cr1tbit/antcontroller/antController.kicad_pcb

## KiCad design antController.kicad_pcb (2022-12-12)

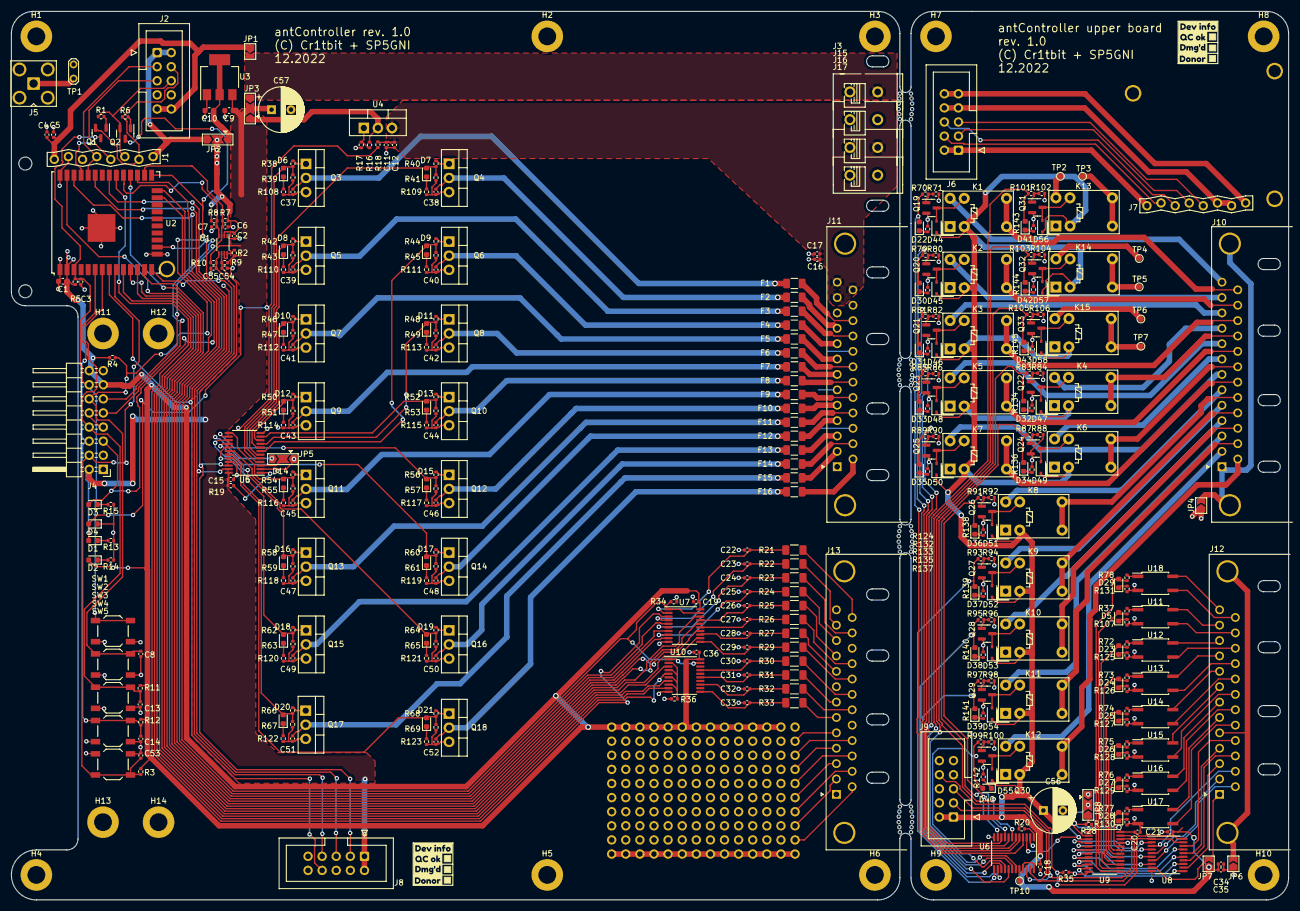
[picture p1: board antController.kicad_pcb from above]

Board: 2 copper layers, 230.0 x 160.0 mm, 402 parts (0 on the bottom side), 326 nets.

Parts:
C1, C9, C10: 10u; C_0603_1608Metric
C2, C3, C4, C8, C11, C13, C14, C15, C16, C18, C19, C20, C21, C34, C36, C53: 100n; C_0402_1005Metric
C5, C12, C17, C35: 1n; C_0402_1005Metric
C6, C7, C54, C55: 1n/DNP; C_0402_1005Metric
C22, C23, C24, C25, C26, C27, C28, C29, C30, C31, C32, C33, C37, C38, C39, C40, C41, C42, C43, C44, C45, C46, C47, C48, C49, C50, C51, C52: 10n; C_0402_1005Metric
C56, C57: 220u; CP_Radial_D8.0mm_P3.50mm
D1, D2, D3, D4, D5, D6, D7, D8, D9, D10, D11, D12, D13, D14, D15, D16, D17, D18, D19, D20, D21, D22, D23, D24, D25, D26, D27, D28, D29, D30, D31, D32, D33, D34, D35, D36, D37, D38, D39, D40, D41, D42, D43: LED_RED; LED_0603_1608Metric
D44, D45, D46, D47, D48, D49, D50, D51, D52, D53, D54, D55, D56, D57, D58: 1N4148WS; D_SOD-323
F1, F2, F3, F4, F5, F6, F7, F8, F9, F10, F11, F12, F13, F14, F15, F16: FUSE_1206; Fuse_1206_3216Metric
H1, H2, H3, H4, H5, H6, H11, H12, H13, H14: SCRHOLE; MountingHole_3.2mm_M3_ISO7380_Pad
H7, H8, H9, H10: HOLE_B2; MountingHole_3.2mm_M3_ISO7380_Pad
J1, J7: Lichtenprog_conn; Lichtenprog_board
J2, J6, J8, J9: IDC10; IDC-Header_2x05_P2.54mm_Vertical
J3, J15, J16, J17: VIN; DG235-5.0
J4: FRONT_PANEL; PinHeader_2x08_P2.54mm_Horizontal
J5: SMA CONN; SMA_Amphenol_901-143_Horizontal
J10, J11, J12, J13: DB25_Male_MountingHoles; DSUB-25_Male_Horizontal_P2.77x2.84mm_EdgePinOffset9.90mm_Ho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
J14: Proto_matrix_14x10
JP1: 5V_PROG; SolderJumper-2_P1.3mm_Open_TrianglePad1.0x1.5mm
JP2: 3V3_SEL; SolderJumper-3_P2.0mm_Open_TrianglePad1.0x1.5mm
JP3: 5V_SEL; SolderJumper-3_P2.0mm_Open_TrianglePad1.0x1.5mm
JP4, JP6: GND_CONN; SolderJumper-2_P1.3mm_Open_TrianglePad1.0x1.5mm
JP5, JP8: IOEX_A2_SEL; SolderJumper-3_P2.0mm_Open_TrianglePad1.0x1.5mm
JP7: 5V_CONN; SolderJumper-2_P1.3mm_Open_TrianglePad1.0x1.5mm
K1, K2, K3, K4, K5, K6, K7, K8, K9, K10, K11, K12, K13, K14, K15: G5V-1; Relay_SPDT_Omron_G5V-1
Q1, Q2, Q19, Q20, Q21, Q22, Q23, Q24, Q25, Q26, Q27, Q28, Q29, Q30, Q31, Q32, Q33: MMBT3904; SOT-23
Q3, Q4, Q5, Q6, Q7, Q8, Q9, Q10, Q11, Q12, Q13, Q14, Q15, Q16, Q17, Q18: BUZ11; TO-220-3_Vertical
R1, R3, R4, R5, R6, R11, R12, R19, R20, R28, R34, R35, R36, R39, R41, R43, R45, R47, R49, R51, R53, R55, R57, R59, R61, R63, R65, R67, R69, R71, R80, R82, R84, R86, R88, R90, R92, R94, R96, R98, R100, R102, R104, R106: 10k; R_0402_1005Metric
R2: 200k; R_0402_1005Metric
R7, R8, R9, R10, R37, R38, R40, R42, R44, R46, R48, R50, R52, R54, R56, R58, R60, R62, R64, R66, R68, R70, R72, R73, R74, R75, R76, R77, R78, R79, R81, R83, R85, R87, R89, R91, R93, R95, R97, R99, R101, R103, R105: 4k7; R_0402_1005Metric
R13, R107, R108, R109, R110, R111, R112, R113, R114, R115, R116, R117, R118, R119, R120, R121, R122, R123, R124, R125, R126, R127, R128, R129, R130, R131, R132, R133, R134, R135, R136, R137, R138, R139, R140, R141, R142, R143, R144, R145: 33k; R_0402_1005Metric
R14, R15: 15k; R_0402_1005Metric
R16: 240; R_0402_1005Metric
R17: 720; R_0402_1005Metric
R18: 100k; R_0402_1005Metric
R21, R22, R23, R24, R25, R26, R27, R29, R30, R31, R32, R33: 10k_1206; R_1206_3216Metric_Pad1.30x1.75mm_HandSolder
SW1: B_RST; SW_SPST_TL3342
SW2: B1/BOOT; SW_SPST_TL3342
SW3: B2; SW_SPST_TL3342
SW4, SW5: B3; SW_SPST_TL3342
TP1: SMA PADS; TestPoint_2Pads_Pitch2.54mm_Drill0.8mm
TP2, TP3, TP4, TP5, TP6, TP7: RLPAD; TestPoint_Pad_D1.0mm
TP10: IOPAD; TestPoint_Pad_D1.0mm
U1: PCA9306DC; VSSOP-8_2.3x2mm_P0.5mm
U2: ESP32-WROOM-32U
U3: AZ1117-3.3; SOT-223-3_TabPin2
U4: LM317_TO-220; TO-220-3_Vertical
U5, U6, U9: PCA9555PW; TSSOP-24_4.4x7.8mm_P0.65mm
U7, U8, U10: 74HC244; TSSOP-20_4.4x6.5mm_P0.65mm
U11, U12, U13, U14, U15, U16, U17, U18: LTV-356T; SO-4_4.4x3.6mm_P2.54mm
kibuzzard-6394C46A, kibuzzard-6394C46A#2: G***; kibuzzard-6394C46A
kibuzzard-6394C47E, kibuzzard-6394C47E#2: G***; kibuzzard-6394C47E
kibuzzard-6394C445, kibuzzard-6394C445#2: G***; kibuzzard-6394C445
kibuzzard-6394C560, kibuzzard-6394C560#2: G***; kibuzzard-6394C560

Connections:
+3.3V: C1.1, C2.1, C19.1, C36.1, D2.2 (A), J4.13, J4.16, J14.A2, J14.A3, J14.A4, J14.A5, J14.A6, J14.A7, J14.A8, J14.A9, J14.A10, J14.A11, J14.A12, J14.A13, J14.A14, JP2.2 (C), R3.2, R4.2, R5.2, R7.2, R8.2, R11.2, R12.2, U1.2 (VREF1), U2.2 (VDD), U7.20 (VCC), U10.20 (VCC)
+5V: C9.1, C15.1, C57.1, D1.2 (A), J4.2, J8.1, J8.2, JP3.2 (C), JP5.3 (B), R2.2, R9.2, R10.2, R19.2, U3.3 (VI), U5.24 (VDD)
+5VD: C18.1, C20.1, C21.1, C34.2, C35.2, C56.1, D44.1 (K), D45.1 (K), D46.1 (K), D47.1 (K), D48.1 (K), D49.1 (K), D50.1 (K), D51.1 (K), D52.1 (K), D53.1 (K), D54.1 (K), D55.1 (K), D56.1 (K), D57.1 (K), D58.1 (K), J9.1, J9.2, JP7.1 (A), JP8.3 (B), K1.2, K2.2, K3.2, K4.2, K5.2, K6.2, K7.2, K8.2, K9.2, K10.2, K11.2, K12.2, K13.2, K14.2, K15.2, R20.2, R28.2, U6.21 (A0), U6.24 (VDD), U8.20 (VCC), U9.2 (A1), U9.24 (VDD)
+VDC: C11.1, C12.1, C16.1, C17.1, J11.12, J11.13, J11.25, J16.1, R18.2, U4.3 (VI)
/5V_IN: J3.1, JP1.2 (B), JP3.3 (B)
/B2: C13.1, J4.8, R11.1, SW3.2, U2.7 (IO35)
/B3: C14.1, J4.6, R12.1, SW4.2, U2.6 (IO34)
/B4: C53.1, J4.4, R3.1, SW5.2, U2.9 (IO33)
/Back connectors/B2_OUT_BUF_ENA: J9.8, R35.2, U8.1 (1OE), U8.19 (2OE)
/Back connectors/B2_PROG_RX: J6.5, J7.5 (PROG_TX)
/Back connectors/B2_PROG_TX: J6.3, J7.4 (PROG_RX)
/Back connectors/B2_SCL: J9.3, U6.23 (SDA), U9.23 (SDA)
/Back connectors/B2_SDA: J9.5, U6.22 (SCL), U9.22 (SCL)
/Back connectors/BUFF1: J12.17, U8.18 (1Y0)
/Back connectors/BUFF2: J12.4, U8.16 (1Y1)
/Back connectors/BUFF3: J12.16, U8.14 (1Y2)
/Back connectors/BUFF4: J12.3, U8.12 (1Y3)
/Back connectors/BUFF5: J12.15, U8.3 (2Y0)
/Back connectors/BUFF6: J12.2, U8.5 (2Y1)
/Back connectors/BUFF7: J12.14, U8.7 (2Y2)
/Back connectors/BUFF8: J12.1, JP7.2 (B), U8.9 (2Y3)
/Back connectors/G_SINK1: D6.2 (A), R38.2, R39.2, U5.4 (IO0_0)
/Back connectors/G_SINK2: D7.2 (A), R40.2, R41.2, U5.5 (IO0_1)
/Back connectors/G_SINK3: D8.2 (A), R42.2, R43.2, U5.6 (IO0_2)
/Back connectors/G_SINK4: D9.2 (A), R44.2, R45.2, U5.7 (IO0_3)
/Back connectors/G_SINK5: D10.2 (A), R46.2, R47.2, U5.8 (IO0_4)
/Back connectors/G_SINK6: D11.2 (A), R48.2, R49.2, U5.9 (IO0_5)
/Back connectors/G_SINK7: D12.2 (A), R50.2, R51.2, U5.10 (IO0_6)
/Back connectors/G_SINK8: D13.2 (A), R52.2, R53.2, U5.11 (IO0_7)
/Back connectors/G_SINK9: D14.2 (A), R54.2, R55.2, U5.13 (IO1_0)
/Back connectors/G_SINK10: D15.2 (A), R56.2, R57.2, U5.14 (IO1_1)
/Back connectors/G_SINK11: D16.2 (A), R58.2, R59.2, U5.15 (IO1_2)
/Back connectors/G_SINK12: D17.2 (A), R60.2, R61.2, U5.16 (IO1_3)
/Back connectors/G_SINK13: D18.2 (A), R62.2, R63.2, U5.17 (IO1_4)
/Back connectors/G_SINK14: D19.2 (A), R64.2, R65.2, U5.18 (IO1_5)
/Back connectors/G_SINK15: D20.2 (A), R66.2, R67.2, U5.19 (IO1_6)
/Back connectors/G_SINK16: D21.2 (A), R68.2, R69.2, U5.20 (IO1_7)
/Back connectors/OC1_A: D29.2 (A), R78.2, U9.13 (IO1_0)
/Back connectors/OC1_C: J12.13, U18.4
/Back connectors/OC1_E: J12.25, U18.3
/Back connectors/OC2_A: D5.2 (A), R37.2, U9.14 (IO1_1)
/Back connectors/OC2_C: J12.12, U11.4
/Back connectors/OC2_E: J12.24, U11.3
/Back connectors/OC3_A: D23.2 (A), R72.2, U9.15 (IO1_2)
/Back connectors/OC3_C: J12.11, U12.4
/Back connectors/OC3_E: J12.23, U12.3
/Back connectors/OC4_A: D24.2 (A), R73.2, U9.16 (IO1_3)
/Back connectors/OC4_C: J12.10, U13.4
/Back connectors/OC4_E: J12.22, U13.3
/Back connectors/OC5_A: D25.2 (A), R74.2, U9.17 (IO1_4)
/Back connectors/OC5_C: J12.9, U14.4
/Back connectors/OC5_E: J12.21, U14.3
/Back connectors/OC6_A: D26.2 (A), R75.2, U9.18 (IO1_5)
/Back connectors/OC6_C: J12.8, U15.4
/Back connectors/OC6_E: J12.20, U15.3
/Back connectors/OC7_A: D27.2 (A), R76.2, U9.19 (IO1_6)
/Back connectors/OC7_C: J12.7, U16.4
/Back connectors/OC7_E: J12.19, U16.3
/Back connectors/OC8_A: D28.2 (A), R77.2, U9.20 (IO1_7)
/Back connectors/OC8_C: J12.6, U17.4
/Back connectors/OC8_E: J12.18, U17.3
/Back connectors/RL1_A: J10.13, K1.10
/Back connectors/RL1_B: J10.25, K1.5, K1.6
/Back connectors/RL2_A: J10.12, K2.10
/Back connectors/RL2_B: J10.24, K2.5, K2.6
/Back connectors/RL3_A: J10.11, K3.10
/Back connectors/RL3_B: J10.23, K3.5, K3.6
/Back connectors/RL4_A: J10.10, K4.10
/Back connectors/RL4_B: J10.22, K4.5, K4.6
/Back connectors/RL5_A: J10.9, K5.10
/Back connectors/RL5_B: J10.21, K5.5, K5.6
/Back connectors/RL6_A: J10.8, K6.10
/Back connectors/RL6_B: J10.20, K6.5, K6.6
/Back connectors/RL7_A: J10.7, K7.10
/Back connectors/RL7_B: J10.19, K7.5, K7.6
/Back connectors/RL8_A: J10.6, K8.10
/Back connectors/RL8_B: J10.18, K8.5, K8.6
/Back connectors/RL9_A: J10.5, K9.10
/Back connectors/RL9_B: J10.17, K9.5, K9.6
/Back connectors/RL10_A: J10.4, K10.10
/Back connectors/RL10_B: J10.16, K10.5, K10.6
/Back connectors/RL11_A: J10.3, K11.10
/Back connectors/RL11_B: J10.15, K11.5, K11.6
/Back connectors/RL12_A: J10.2, K12.10
/Back connectors/RL12_B: J10.14, K12.5, K12.6
/Back connectors/RL13_A: K13.10, TP2.1
/Back connectors/RL13_B: K13.5, K13.6, TP3.1
/Back connectors/RL14_A: K14.10, TP4.1
/Back connectors/RL14_B: K14.5, K14.6, TP5.1
/Back connectors/RL15_A: K15.10, TP6.1
/Back connectors/RL15_B: K15.5, K15.6, TP7.1
/Back connectors/RL_CTRL1: D22.2 (A), R70.2, U6.4 (IO0_0)
/Back connectors/RL_CTRL2: D30.2 (A), R79.2, U6.5 (IO0_1)
/Back connectors/RL_CTRL3: D31.2 (A), R81.2, U6.6 (IO0_2)
/Back connectors/RL_CTRL4: D32.2 (A), R83.2, U6.7 (IO0_3)
/Back connectors/RL_CTRL5: D33.2 (A), R85.2, U6.8 (IO0_4)
/Back connectors/RL_CTRL6: D34.2 (A), R87.2, U6.9 (IO0_5)
/Back connectors/RL_CTRL7: D35.2 (A), R89.2, U6.10 (IO0_6)
/Back connectors/RL_CTRL8: D36.2 (A), R91.2, U6.11 (IO0_7)
/Back connectors/RL_CTRL9: D37.2 (A), R93.2, U6.13 (IO1_0)
/Back connectors/RL_CTRL10: D38.2 (A), R95.2, U6.14 (IO1_1)
/Back connectors/RL_CTRL11: D39.2 (A), R97.2, U6.15 (IO1_2)
/Back connectors/RL_CTRL12: D40.2 (A), R99.2, U6.16 (IO1_3)
/Back connectors/RL_CTRL13: D41.2 (A), R101.2, U6.17 (IO1_4)
/Back connectors/RL_CTRL14: D42.2 (A), R103.2, U6.18 (IO1_5)
/Back connectors/RL_CTRL15: D43.2 (A), R105.2, U6.19 (IO1_6)
/Back connectors/SINK1: C37.1, F1.1, Q3.2 (D)
/Back connectors/SINK2: C38.1, F2.1, Q4.2 (D)
/Back connectors/SINK3: C39.1, F3.1, Q5.2 (D)
/Back connectors/SINK4: C40.1, F4.1, Q6.2 (D)
/Back connectors/SINK5: C41.1, F5.1, Q7.2 (D)
/Back connectors/SINK6: C42.1, F6.1, Q8.2 (D)
/Back connectors/SINK7: C43.1, F7.1, Q9.2 (D)
/Back connectors/SINK8: C44.1, F8.1, Q10.2 (D)
/Back connectors/SINK9: C45.1, F9.1, Q11.2 (D)
/Back connectors/SINK10: C46.1, F10.1, Q12.2 (D)
/Back connectors/SINK11: C47.1, F11.1, Q13.2 (D)
/Back connectors/SINK12: C48.1, F12.1, Q14.2 (D)
/Back connectors/SINK13: C49.1, F13.1, Q15.2 (D)
/Back connectors/SINK14: C50.1, F14.1, Q16.2 (D)
/Back connectors/SINK15: C51.1, F15.1, Q17.2 (D)
/Back connectors/SINK16: C52.1, F16.1, Q18.2 (D)
/ESP_BOOT: C8.1, J4.12, Q2.3 (C), R4.1, SW2.2, U2.25 (IO0)
/ESP_EN: C3.1, J4.14, Q1.3 (C), R5.1, SW1.2, U2.3 (EN)
/I2C_RST: J8.7, U2.14 (IO12)
/IN_BUFF_ENA: R34.2, U2.16 (IO13), U7.1 (1OE), U7.19 (2OE), U10.1 (1OE), U10.19 (2OE)
/IO14: U2.13 (IO14), U7.18 (1Y0)
/IO15: U2.23 (IO15), U7.16 (1Y1)
/IO16: U2.27 (IO16), U7.14 (1Y2)
/IO17: U2.28 (IO17), U7.12 (1Y3)
/IO18: U2.30 (IO18), U7.3 (2Y0)
/IO19: U2.31 (IO19), U7.5 (2Y1)
/IO21: U2.33 (IO21), U7.7 (2Y2)
/IO22: U2.36 (IO22), U7.9 (2Y3)
/IO23: U2.37 (IO23), U10.3 (2Y0)
/IO25: U2.10 (IO25), U10.5 (2Y1)
/IO26: U2.11 (IO26), U10.7 (2Y2)
/IO27: U2.12 (IO27), U10.9 (2Y3)
/LED_STATUS: D3.2 (A), J4.5, U2.24 (IO2)
/OUT_BUF_ENA: J8.8, U2.8 (IO32)
/PROG_3V3: J1.1 (VDD), J2.1, J2.2, JP2.3 (B)
/PROG_5V: C4.1, C5.1, J1.8 (5V), J2.9, J2.10, JP1.1 (A)
/PROG_DTR: J1.3 (DTR), J2.6, Q2.2 (E), R1.1
/PROG_RTS: J1.2 (RTS), J2.4, Q1.2 (E), R6.1
/RXD: J1.5 (PROG_TX), J2.3, U2.34 (RXD0/IO3)
/SCL: C6.1, J4.11, R7.1, U1.3 (SCL1), U2.26 (IO4)
/SCL_5V: C54.1, J8.3, R9.1, U1.6 (SCL2), U5.22 (SCL)
/SDA: C7.1, J4.9, R8.1, U1.4 (SDA1), U2.29 (IO5)
/SDA_5V: C55.1, J8.5, R10.1, U1.5 (SDA2), U5.23 (SDA)
/TXD: J1.4 (PROG_RX), J2.5, U2.35 (TXD0/IO1)
GND: C1.2, C2.2, C3.2, C4.2, C5.2, C6.2, C7.2, C8.2, C9.2, C10.2, C11.2, C12.2, C13.2, C14.2, C15.2, C16.2, C17.2, C19.2, C22.2, C23.2, C24.2, C25.2, C26.2, C27.2, C28.2, C29.2, C30.2, C31.2, C32.2, C33.2, C36.2, C37.2, C38.2, C39.2, C40.2, C41.2, C42.2, C43.2, C44.2, C45.2, C46.2, C47.2, C48.2, C49.2, C50.2, C51.2, C52.2, C53.2, C54.2, C55.2, C57.2, D4.1 (K), H1.1, H2.1, H3.1, H4.1, H5.1, H6.1, H11.1, H12.1, H13.1, H14.1, J1.6 (GND), J1.7 (GND), J2.7, J2.8, J4.7, J4.10, J4.15, J5.2 (Ext), J8.9, J8.10, J11.0 (PAD), J11.1, J11.6, J11.11, J11.16, J11.21, J11.24, J13.0 (PAD), J13.1, J13.8, J13.13, J13.18, J13.23, J14.A1, J14.J1, J14.J2, J14.J3, J14.J4, J14.J5, J14.J6, J14.J7, J14.J8, J14.J9, J14.J10, J14.J11, J14.J12, J14.J13, J14.J14, J15.1, J17.1, JP5.1 (A), Q3.3 (S), Q4.3 (S), Q5.3 (S), Q6.3 (S), Q7.3 (S), Q8.3 (S), Q9.3 (S), Q10.3 (S), Q11.3 (S), Q12.3 (S), Q13.3 (S), Q14.3 (S), Q15.3 (S), Q16.3 (S), Q17.3 (S), Q18.3 (S), R13.1, R14.1, R15.1, R17.1, R34.1, R36.1, R39.1, R41.1, R43.1, R45.1, R47.1, R49.1, R51.1, R53.1, R55.1, R57.1, R59.1, R61.1, R63.1, R65.1, R67.1, R69.1, R108.1, R109.1, R110.1, R111.1, R112.1, R113.1, R114.1, R115.1, R116.1, R117.1, R118.1, R119.1, R120.1, R121.1, R122.1, R123.1, SW1.1, SW2.1, SW3.1, SW4.1, SW5.1, TP1.1, U1.1 (GND), U2.1 (GND), U2.15 (GND), U2.38 (GND), U2.39 (GND), U3.1 (GND), U5.2 (A1), U5.12 (VSS), U5.21 (A0), U7.10 (GND), U10.10 (GND)
GND2: C18.2, C20.2, C21.2, C34.1, C35.1, C56.2, H7.1, H8.1, H9.1, H10.1, J9.9, J9.10, JP4.1 (A), JP6.1 (A), JP8.1 (A), Q19.2 (E), Q20.2 (E), Q21.2 (E), Q22.2 (E), Q23.2 (E), Q24.2 (E), Q25.2 (E), Q26.2 (E), Q27.2 (E), Q28.2 (E), Q29.2 (E), Q30.2 (E), Q31.2 (E), Q32.2 (E), Q33.2 (E), R35.1, R71.1, R80.1, R82.1, R84.1, R86.1, R88.1, R90.1, R92.1, R94.1, R96.1, R98.1, R100.1, R102.1, R104.1, R106.1, R107.1, R124.1, R125.1, R126.1, R127.1, R128.1, R129.1, R130.1, R131.1, R132.1, R133.1, R134.1, R135.1, R136.1, R137.1, R138.1, R139.1, R140.1, R141.1, R142.1, R143.1, R144.1, R145.1, U6.2 (A1), U6.12 (VSS), U8.10 (GND), U9.12 (VSS), U9.21 (A0), U11.2, U12.2, U13.2, U14.2, U15.2, U16.2, U17.2, U18.2
unnamed: C10.1, JP2.1 (A), U3.2 (VO)
unnamed: C22.1, R21.2, U7.2 (1A0)
unnamed: C23.1, R22.2, U7.4 (1A1)
unnamed: C24.1, R23.2, U7.6 (1A2)
unnamed: C25.1, R24.2, U7.8 (1A3)
unnamed: C26.1, R25.2, U7.17 (2A0)
unnamed: C27.1, R26.2, U7.15 (2A1)
unnamed: C28.1, R27.2, U7.13 (2A2)
unnamed: C29.1, R29.2, U7.11 (2A3)
unnamed: C30.1, R30.2, U10.17 (2A0)
unnamed: C31.1, R31.2, U10.15 (2A1)
unnamed: C32.1, R32.2, U10.13 (2A2)
unnamed: C33.1, R33.2, U10.11 (2A3)
unnamed: D1.1 (K), R13.2
unnamed: D2.1 (K), R14.2
unnamed: D3.1 (K), R15.2
unnamed: D4.2 (A), R18.1
unnamed: D5.1 (K), R107.2
unnamed: D6.1 (K), R108.2
unnamed: D7.1 (K), R109.2
unnamed: D8.1 (K), R110.2
unnamed: D9.1 (K), R111.2
unnamed: D10.1 (K), R112.2
unnamed: D11.1 (K), R113.2
unnamed: D12.1 (K), R114.2
unnamed: D13.1 (K), R115.2
unnamed: D14.1 (K), R116.2
unnamed: D15.1 (K), R117.2
unnamed: D16.1 (K), R118.2
unnamed: D17.1 (K), R119.2
unnamed: D18.1 (K), R120.2
unnamed: D19.1 (K), R121.2
unnamed: D20.1 (K), R122.2
unnamed: D21.1 (K), R123.2
unnamed: D22.1 (K), R124.2
unnamed: D23.1 (K), R125.2
unnamed: D24.1 (K), R126.2
unnamed: D25.1 (K), R127.2
unnamed: D26.1 (K), R128.2
unnamed: D27.1 (K), R129.2
unnamed: D28.1 (K), R130.2
unnamed: D29.1 (K), R131.2
unnamed: D30.1 (K), R132.2
unnamed: D31.1 (K), R133.2
unnamed: D32.1 (K), R134.2
unnamed: D33.1 (K), R135.2
unnamed: D34.1 (K), R136.2
unnamed: D35.1 (K), R137.2
unnamed: D36.1 (K), R138.2
unnamed: D37.1 (K), R139.2
unnamed: D38.1 (K), R140.2
unnamed: D39.1 (K), R141.2
unnamed: D40.1 (K), R142.2
unnamed: D41.1 (K), R143.2
unnamed: D42.1 (K), R144.2
unnamed: D43.1 (K), R145.2
unnamed: D44.2 (A), K1.9, Q19.3 (C)
unnamed: D45.2 (A), K2.9, Q20.3 (C)
unnamed: D46.2 (A), K3.9, Q21.3 (C)
unnamed: D47.2 (A), K4.9, Q22.3 (C)
unnamed: D48.2 (A), K5.9, Q23.3 (C)
unnamed: D49.2 (A), K6.9, Q24.3 (C)
unnamed: D50.2 (A), K7.9, Q25.3 (C)
unnamed: D51.2 (A), K8.9, Q26.3 (C)
unnamed: D52.2 (A), K9.9, Q27.3 (C)
unnamed: D53.2 (A), K10.9, Q28.3 (C)
unnamed: D54.2 (A), K11.9, Q29.3 (C)
unnamed: D55.2 (A), K12.9, Q30.3 (C)
unnamed: D56.2 (A), K13.9, Q31.3 (C)
unnamed: D57.2 (A), K14.9, Q32.3 (C)
unnamed: D58.2 (A), K15.9, Q33.3 (C)
unnamed: F1.2, J11.23
unnamed: F2.2, J11.10
unnamed: F3.2, J11.22
unnamed: F4.2, J11.9
unnamed: F5.2, J11.8
unnamed: F6.2, J11.20
unnamed: F7.2, J11.7
unnamed: F8.2, J11.19
unnamed: F9.2, J11.18
unnamed: F10.2, J11.5
unnamed: F11.2, J11.17
unnamed: F12.2, J11.4
unnamed: F13.2, J11.3
unnamed: F14.2, J11.15
unnamed: F15.2, J11.2
unnamed: F16.2, J11.14
unnamed: J5.1 (In), TP1.2
unnamed: J6.1, J6.2, J7.1 (VDD)
unnamed: J6.4, J7.2 (RTS)
unnamed: J6.6, J7.3 (DTR)
unnamed: J6.7, J6.8, J7.6 (GND), J7.7 (GND)
unnamed: J6.9, J6.10, J7.8 (5V)
unnamed: J10.0 (PAD), J10.1, JP4.2 (B)
unnamed: J12.0 (PAD), J12.5, JP6.2 (B)
unnamed: J13.2, J14.H1
unnamed: J13.3, J14.F1
unnamed: J13.4, J14.D1
unnamed: J13.5, J14.B1
unnamed: J13.6, R33.1
unnamed: J13.7, R31.1
unnamed: J13.9, R27.1
unnamed: J13.10, R25.1
unnamed: J13.11, R24.1
unnamed: J13.12, R22.1
unnamed: J13.14, J14.I1
unnamed: J13.15, J14.G1
unnamed: J13.16, J14.E1
unnamed: J13.17, J14.C1
unnamed: J13.19, R32.1
unnamed: J13.20, R30.1
unnamed: J13.21, R29.1
unnamed: J13.22, R26.1
unnamed: J13.24, R23.1
unnamed: J13.25, R21.1
unnamed: JP3.1 (A), R16.1, U4.2 (VO)
unnamed: JP5.2 (C), U5.3 (A2)
unnamed: JP8.2 (C), U6.3 (A2), U9.3 (A2)
unnamed: Q1.1 (B), R1.2
unnamed: Q2.1 (B), R6.2
unnamed: Q3.1 (G), R38.1
unnamed: Q4.1 (G), R40.1
unnamed: Q5.1 (G), R42.1
unnamed: Q6.1 (G), R44.1
unnamed: Q7.1 (G), R46.1
unnamed: Q8.1 (G), R48.1
unnamed: Q9.1 (G), R50.1
unnamed: Q10.1 (G), R52.1
unnamed: Q11.1 (G), R54.1
unnamed: Q12.1 (G), R56.1
unnamed: Q13.1 (G), R58.1
unnamed: Q14.1 (G), R60.1
unnamed: Q15.1 (G), R62.1
unnamed: Q16.1 (G), R64.1
unnamed: Q17.1 (G), R66.1
unnamed: Q18.1 (G), R68.1
unnamed: Q19.1 (B), R70.1, R71.2
unnamed: Q20.1 (B), R79.1, R80.2
unnamed: Q21.1 (B), R81.1, R82.2
unnamed: Q22.1 (B), R83.1, R84.2
unnamed: Q23.1 (B), R85.1, R86.2
unnamed: Q24.1 (B), R87.1, R88.2
unnamed: Q25.1 (B), R89.1, R90.2
unnamed: Q26.1 (B), R91.1, R92.2
unnamed: Q27.1 (B), R93.1, R94.2
unnamed: Q28.1 (B), R95.1, R96.2
unnamed: Q29.1 (B), R97.1, R98.2
unnamed: Q30.1 (B), R99.1, R100.2
unnamed: Q31.1 (B), R101.1, R102.2
unnamed: Q32.1 (B), R103.1, R104.2
unnamed: Q33.1 (B), R105.1, R106.2
unnamed: R2.1, U1.7 (VREF2), U1.8 (EN)
unnamed: R16.2, R17.2, U4.1 (ADJ)
unnamed: R19.1, U5.1 (~INT)
unnamed: R20.1, U6.1 (~INT)
unnamed: R28.1, U9.1 (~INT)
unnamed: R36.2, U10.2 (1A0), U10.4 (1A1), U10.6 (1A2), U10.8 (1A3)
unnamed: R37.1, U11.1
unnamed: R72.1, U12.1
unnamed: R73.1, U13.1
unnamed: R74.1, U14.1
unnamed: R75.1, U15.1
unnamed: R76.1, U16.1
unnamed: R77.1, U17.1
unnamed: R78.1, U18.1
unnamed: TP10.1, U6.20 (IO1_7)
unnamed: U8.2 (1A0), U9.4 (IO0_0)
unnamed: U8.4 (1A1), U9.5 (IO0_1)
unnamed: U8.6 (1A2), U9.6 (IO0_2)
unnamed: U8.8 (1A3), U9.7 (IO0_3)
unnamed: U8.11 (2A3), U9.11 (IO0_7)
unnamed: U8.13 (2A2), U9.10 (IO0_6)
unnamed: U8.15 (2A1), U9.9 (IO0_5)
unnamed: U8.17 (2A0), U9.8 (IO0_4)
