cr1tbit/antcontroller/(commit log)

2022-11-06 work on schematic
    [antController.kicad_sch]
2022-12-05 finish schematic, work on layout
    [antController.kicad_pcb, antController.kicad_sch, back_connectors.kicad_sch, nmos_sw.kicad_sch, optocoupler.kicad_sch, relay.kicad_sch]
2022-12-06 routing mostly done, fixing schematic issues
    [antController.kicad_pcb, antController.kicad_sch, back_connectors.kicad_sch, nmos_sw.kicad_sch, optocoupler.kicad_sch, relay.kicad_sch]
2022-12-06 succesfully run replicate layout on relays
    [antController.kicad_pcb]
2022-12-11 finish routing and silk
    [antController.kicad_pcb, antController.kicad_sch, back_connectors.kicad_sch]
2022-12-12 prod files
    [antController-bom.csv, antController.kicad_pcb, antController.kicad_sch, back_connectors.kicad_sch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]
2022-12-30 add library for controling device IO
2022-12-31 PoC API call for IO
    [antController.kicad_sch]
2023-01-05 define output API, fun with littleFS and SPIFFSEditor
    [antController.kicad_sch]
2023-05-23 fix pin numeration
2023-06-23 fix errors in bits commands
    [ioController.h]
2023-08-21 from future import missing resistors
    [antController.kicad_sch, back_connectors.kicad_sch, nmos_sw.kicad_sch, optocoupler.kicad_sch, relay.kicad_sch]
